al-ibiewi/Hopital-Assistant-Final-Year-Project/schematic_diagram.kicad_sch

## KiCad design schematic_diagram.kicad_sch (2026-09-05)

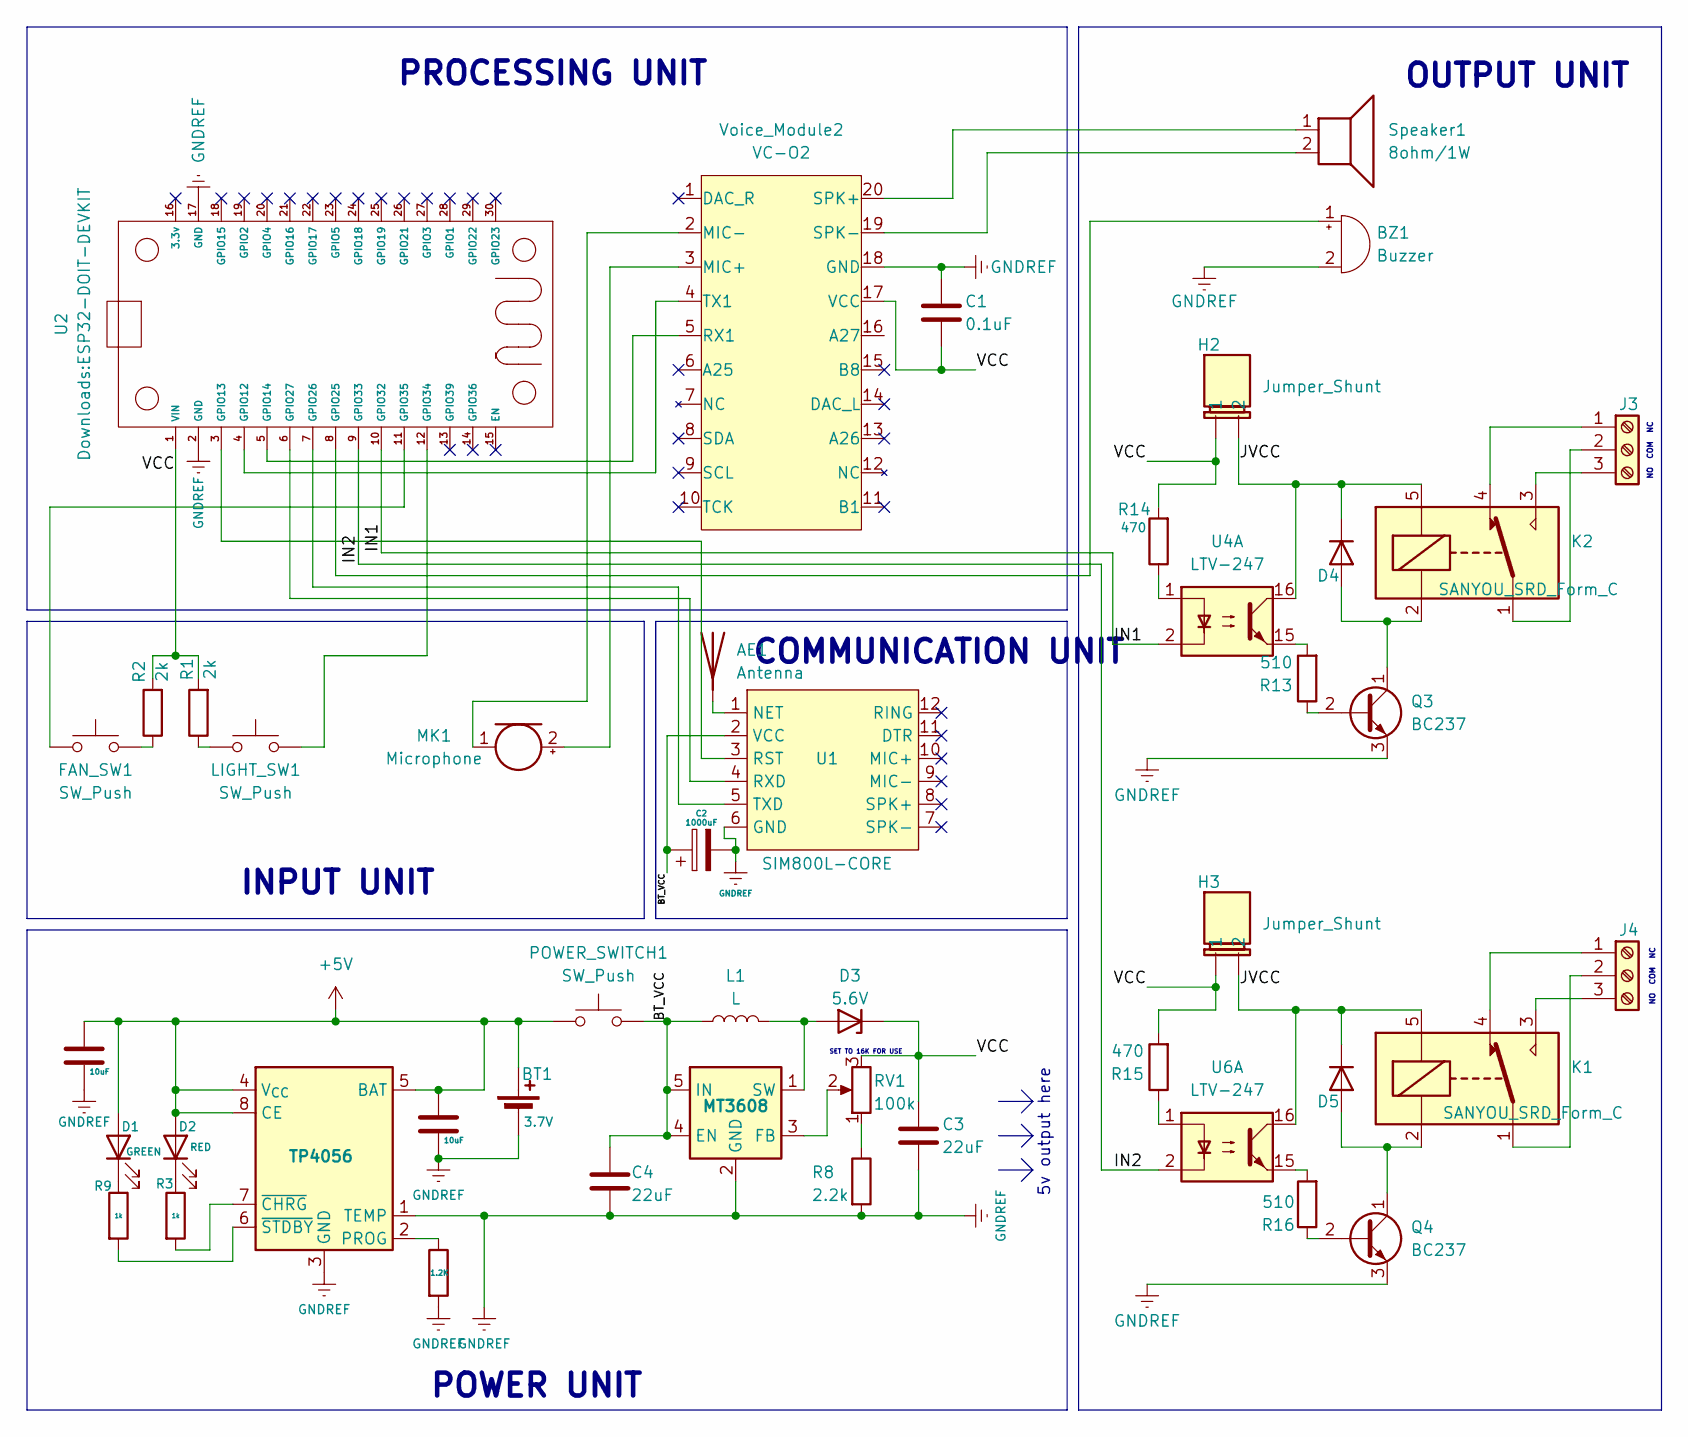
[picture p21: schematic schematic_diagram.kicad_sch]

Parts:
AE1: Antenna; NiceRF_SW868-TH13_868Mhz
BT1: 3.7V; TerminalBlock_Phoenix_MKDS-1,5-2_1x02_P5.00mm_Horizontal
BZ1: Buzzer; Buzzer_15x7.5RM7.6
C1: 0.1uF; C_Radial_D6.3mm_H7.0mm_P2.50mm
C2: 1000uF; C_Radial_D12.5mm_H20.0mm_P5.00mm
C3, C4: 22uF; C_Radial_D10.0mm_H16.0mm_P5.00mm
C5, C6: 10uF; C_Radial_D10.0mm_H16.0mm_P5.00mm
D1: GREEN; LED_0402_1005Metric
D2: RED; LED_0402_1005Metric
D3: 5.6V; D_T-1_P10.16mm_Horizontal
D4, D5: 1N914; D_DO-35_SOD27_P7.62mm_Horizontal
FAN_SW1: SW_Push; SW_BUTT-2
H2, H3: Jumper_Shunt
J3, J4: Screw_Terminal_01x03; TerminalBlock_RND_205-00277_1x03_P5.00mm_Vertical
K1, K2: SANYOU_SRD_Form_C; Relay_SPDT_SANYOU_SRD_Series_Form_C
L1: L; L_Wurth_WE-LQSH-4020
LIGHT_SW1: SW_Push; SW_BUTT-2
MK1: Microphone; POM-2244P-C3310-2-R
POWER_SWITCH1: SW_Push; SW_R1966ABLKBLKGR
Q3, Q4: BC237; TO-92_Inline
R1, R2: 2k; R_0402_1005Metric
R3, R9: 1k; R_0402_1005Metric
R8: 2.2k; R_0402_1005Metric
R11: 1.2K; R_0402_1005Metric
R13, R16: 510; R_0402_1005Metric
R14, R15: 470; R_0402_1005Metric
RV1: 100k; TRIM_2-1625931-5
Speaker1: 8ohm/1W; TerminalBlock_Phoenix_MKDS-1,5-2_1x02_P5.00mm_Horizontal
U1: SIM800L-CORE
U2: ESP32-DOIT-DEVKIT
U3: MT3608; SOT-23-6
U4, U6: LTV-247; SOP-16_4.4x10.4mm_P1.27mm
U5: TP4056; SOIC-8-1EP_3.9x4.9mm_P1.27mm_EP2.41x3.3mm_ThermalVias
Voice_Module2: VC-O2; MODULE_LBAA0QB1SJ-296

Connections:
+5V: BT1.1 (+), C5.1, C6.1, D1.2 (A), D2.2 (A), POWER_SWITCH1.1, U5.4 (V_{CC}), U5.5 (BAT), U5.8 (CE)
BT_VCC: C2.1, C4.1, L1.1, POWER_SWITCH1.2, U1.2 (VCC), U3.4 (EN), U3.5 (IN)
GNDREF: BT1.2 (-), BZ1.2 (-), C1.1, C2.2, C3.2, C4.2, C5.2, C6.2, Q3.3 (E), Q4.3 (E), R8.2, R11.2, U1.6 (GND), U2.2 (GND), U2.17 (GND), U3.2 (GND), U5.1 (TEMP), U5.3 (GND), Voice_Module2.18 (GND)
IN1: U2.10 (GPIO32), U4.2
IN2: U2.9 (GPIO33), U6.2
JVCC: D4.1 (K), D5.1 (K), H2., H3., K1.5, K2.5, U4.16, U6.16
unnamed: AE1.1, U1.1 (NET)
unnamed: BZ1.1 (+), U2.8 (GPIO25)
unnamed: D1.1 (K), R9.1
unnamed: D2.1 (K), R3.1
unnamed: D3.2 (A), L1.2, U3.1 (SW)
unnamed: D4.2 (A), K2.2, Q3.1 (C)
unnamed: D5.2 (A), K1.2, Q4.1 (C)
unnamed: FAN_SW1.1, U2.11 (GPIO35)
unnamed: FAN_SW1.2, R2.1
unnamed: J3.1, K2.4
unnamed: J3.2, K2.1
unnamed: J3.3, K2.3
unnamed: J4.1, K1.4
unnamed: J4.2, K1.1
unnamed: J4.3, K1.3
unnamed: LIGHT_SW1.1, R1.1
unnamed: LIGHT_SW1.2, U2.12 (GPIO34)
unnamed: MK1.1 (-), Voice_Module2.2 (MIC-)
unnamed: MK1.2 (+), Voice_Module2.3 (MIC+)
unnamed: Q3.2 (B), R13.1
unnamed: Q4.2 (B), R16.1
unnamed: R3.2, U5.7 (~CHRG)
unnamed: R8.1, RV1.1
unnamed: R9.2, U5.6 (~STDBY)
unnamed: R11.1, U5.2 (PROG)
unnamed: R13.2, U4.15
unnamed: R14.1, U4.1
unnamed: R15.1, U6.1
unnamed: R16.2, U6.15
unnamed: RV1.2, U3.3 (FB)
unnamed: Speaker1.1, Voice_Module2.20 (SPK+)
unnamed: Speaker1.2, Voice_Module2.19 (SPK-)
unnamed: U1.3 (RST), U2.3 (GPIO13)
unnamed: U1.4 (RXD), U2.6 (GPIO27)
unnamed: U1.5 (TXD), U2.7 (GPIO26)
unnamed: U2.4 (GPIO12), Voice_Module2.4 (TX1)
unnamed: U2.5 (GPIO14), Voice_Module2.5 (RX1)
VCC: C1.2, C3.1, D3.1 (K), H2., H3., R1.2, R2.2, R14.2, R15.2, RV1.3, U2.1 (VIN), Voice_Module2.17 (VCC)

Notes on the sheet:
INPUT UNIT
COM
SET TO 16K FOR USE
OUTPUT UNIT
PROCESSING UNIT
POWER UNIT
5v output here
COMMUNICATION UNIT
