al-ibiewi/Hopital-Assistant-Final-Year-Project/(commit log)

2026-03-30 Add ESP32 code zip and Hospital Assistant APK
    Add two new binary artifacts: 'ESP32 Arduino Complete Code.zip' (ESP32 Arduino project archive) and 'Hospital_Assistant_App.apk' (Android APK for the Hospital Assistant app). Both files are added as new files; consider using Git LFS or release assets for large binaries to avoid inflating the repository history.
2026-04-15 Update ESP32 Arduino code and Android APK
    Replace ESP32 Arduino Complete Code.zip and Hospital_Assistant_App.apk with updated binary builds. These are new versions of the firmware/source bundle and the Android app (no textual diffs to inspect).
2026-09-05 Add multimodal patient PDF document
    Add the "An Offline Edge AI-Based Multimodal Patient.pdf" file to the repository as a new project/reference document.
2026-09-05 Add KiCad schematic diagram
    Add schematic_diagram.kicad_sch (KiCad eeschema v10) for the 'Hopital Assistant Final Year Project' (V2). The file contains the full electrical schematic and symbol instances for power, processing, communication, input/output and battery management: ESP32 (30-pin), SIM800L, VC-02 voice module, TP4056 charger, MT3608 regulator, LTV-247 optocouplers, relays, speakers/buzzer, switches, connectors, passive components and global power nets. Intended as the main schematic for PCB layout and BOM generation.
    [schematic_diagram.kicad_sch]
